ittihadi/keyboards/blog/docs/index.md

---
icon: lucide/home
---

# Home

Welcome to the keyboard blog, where I put my build logs and such related to
keyboard projects that I have

Currently I have one project, my [handwired split keyboard](/Handwired_Split/)
