ittihadi/keyboards/blog/docs/Handwired_Split/long.md

---
icon: lucide/scroll-text
title: Long
---

# Building a Handwired Keyboard (Long Version)

## Background

## Design Considerations

## Initial Design Phase

## Designing the Rest

## Newfound Obstacle

## Assembly

## Finishing Touches

## The Keymap and Firmware

## Summary
