ittihadi/keyboards/final/corne_case_left.scad

use <../corne_case.scad>

case(fn = 50);
