ittihadi/keyboards/final/corne_case_right.scad

use <../corne_case.scad>

mirror([1, 0, 0]) case(fn = 50);
