ittihadi/keyboards/final/corne_mount_plate.scad

use <../corne_mount_plate.scad>
