ittihadi/keyboards/final/corne_pcb_plate_left.scad

use <../corne_pcb_plate.scad>

rotate([ 0, 180, 0 ]) pcb(mirror = false, $fn = 50);
