ittihadi/keyboards/final/corne_pcb_plate_right.scad

use <../corne_pcb_plate.scad>

rotate([ 0, 180, 0 ]) pcb(mirror = true, $fn = 50);
