ittihadi/keyboards/final/corne_top_cover_left.scad

use <../corne_top_cover.scad>

rotate([ 0, 180, 0 ]) cover($fn = 50);
