ittihadi/keyboards/final/corne_top_cover_right.scad

use <../corne_top_cover.scad>

rotate([ 0, 180, 0 ]) mirror([1, 0, 0]) cover($fn = 50);
