ittihadi/keyboards/stl/v2/common.scad

HOLE_THRESHOLD = 0.40;

GRID_UNIT = 19.05;
HOLE_UNIT = 14.00 + HOLE_THRESHOLD;
ROT_UNIT  = -11.94;
PLATE_THICK = 1.5;
