ittihadi/keyboards/(list of files, cad)

Other CAD files:
stl/v1/corne_case.scad
stl/v1/corne_common.scad
stl/v1/corne_config.scad
stl/v1/corne_full_preview.scad
stl/v1/corne_mount_plate.scad
stl/v1/corne_pcb_plate.scad
stl/v1/corne_top_cover.scad
