ittihadi/keyboards/(commit log)

2025-09-29 Add current keymap
2025-09-29 Format switch statements and use shorthand
2025-10-02 Add OpenSCAD files
    [corne_case.scad, corne_case_left.scad, corne_case_right.scad, corne_common.scad, corne_config.scad, corne_full_preview.scad, corne_mount_plate.scad, corne_pcb_plate.scad]
2025-10-12 Mild rearrangmentss
    Move tab so it's accessible by ring finger, add comma, period, and
    underscore to number layer, remove extra tab and shift key from symbol
    layer
2025-10-13 Begin work on second version of case
    [case_full.scad, case_top.scad, common.scad]
2025-10-13 Move v1 files to appropriate folder
    [corne_case.scad, corne_common.scad, corne_config.scad, corne_full_preview.scad, corne_mount_plate.scad, corne_pcb_plate.scad, corne_top_cover.scad]
2025-10-19 Add dedicated key to ctrl+backspace and move printscreen
2026-02-02 Streamline layer switching functionality
    Add layer toggles for sym and nav layers and turn off mouse mode when
    pressing them
    Disable currently pressed keys (excluding mods) when switching to mouse
    mode
2026-03-07 Commit current blog source
    Planning to migrate from 11ty to zensical, commit everything currently
    present to preserve history
